monokuchi/CustomLibraries/README.md

# CustomLibraries
Collection of custom footprints, symbols, and 3D models that can be used with ECAD programs
